Aleksk1/-Tilt_compensated_compass_ATmega328P/Schemes/Compass4_add_grid.pdf

19

20

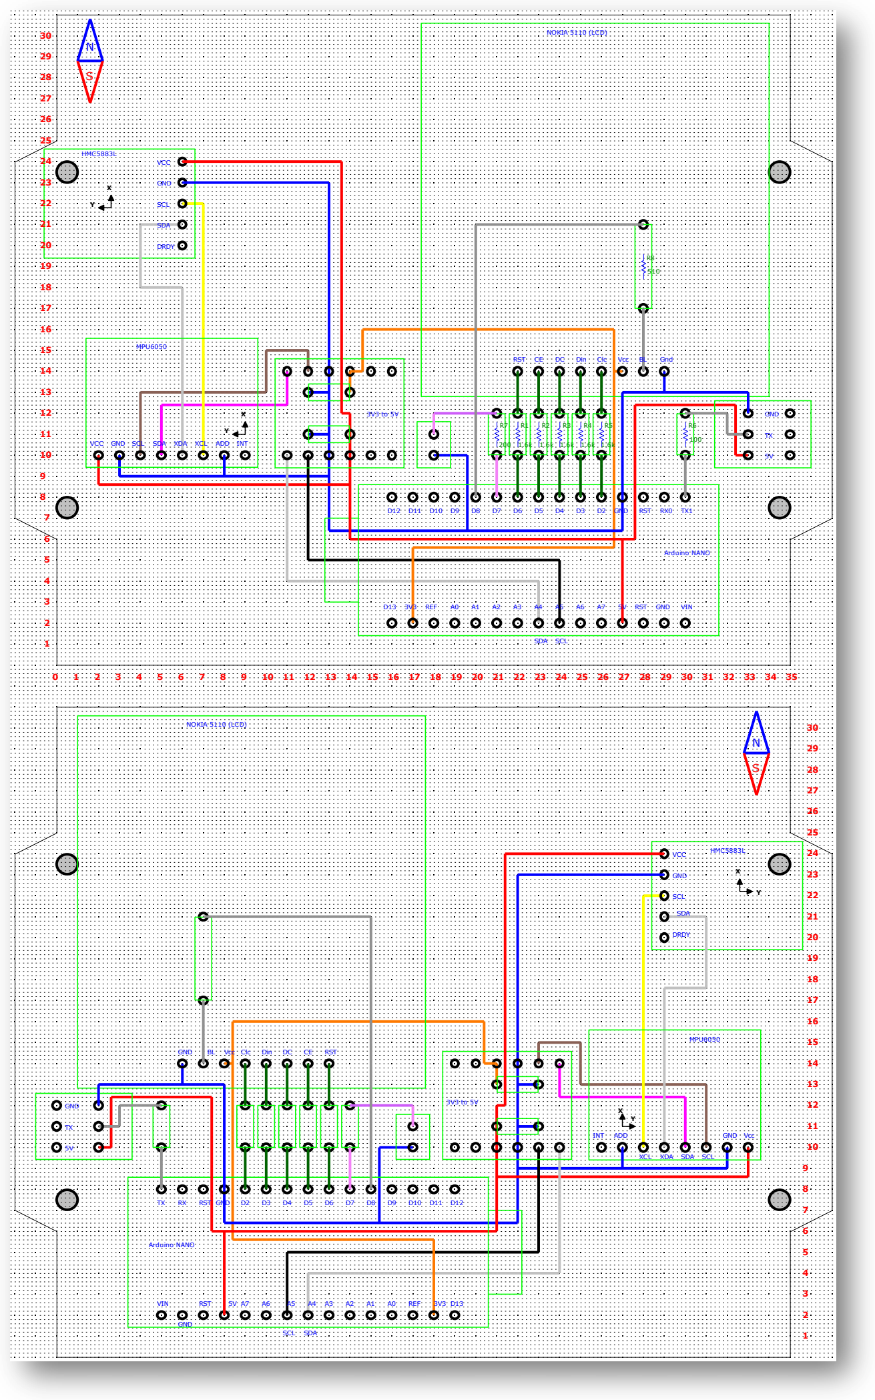
[picture p8: page 1]

R1

1.6k

R2

1.6k

R3

1.6k

R4

1.6k

R5

1.6k

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
1 | 2 | 3 | 4 | 5 | 6 | 7 | 8 | 9 | 10 11 12 13 14 15 16 17 18 19 20 21 22 23 24 25 26 27 28 29 30 31 32

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
RST | CE | DC | Din | Clc | Vcc | BL | Gnd

0 35

N

S

HMC5883L

MPU6050

NOKIA 5110 (LCD)

3V3 to 5V

Arduino NANO

VCC | GND SCL | SDA | XDA | XCL | ADD INT

VCC

GND

SCL

SDA

DRDY

SDA SCL

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
GND | BL | Vcc Clc | Din | DC | CE | RST

N

S

HMC5883L

MPU6050

NOKIA 5110 (LCD)

3V3 to 5V

Arduino NANO

GND Vcc

XCL | XDA | SDA | SCL
INT | ADD

VCC

GND

SCL

SDA

DRDY

SCL SDA

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
33 34
