Aleksk1/-Tilt_compensated_compass_ATmega328P/Photos/freescale_magnetometr.jpg

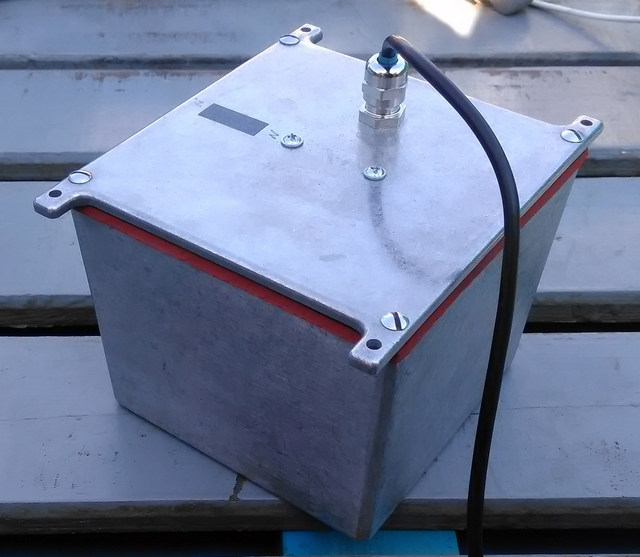
Photos/freescale_magnetometr.jpg
