Aleksk1/-Tilt_compensated_compass_ATmega328P/Schemes/g221c.pdf

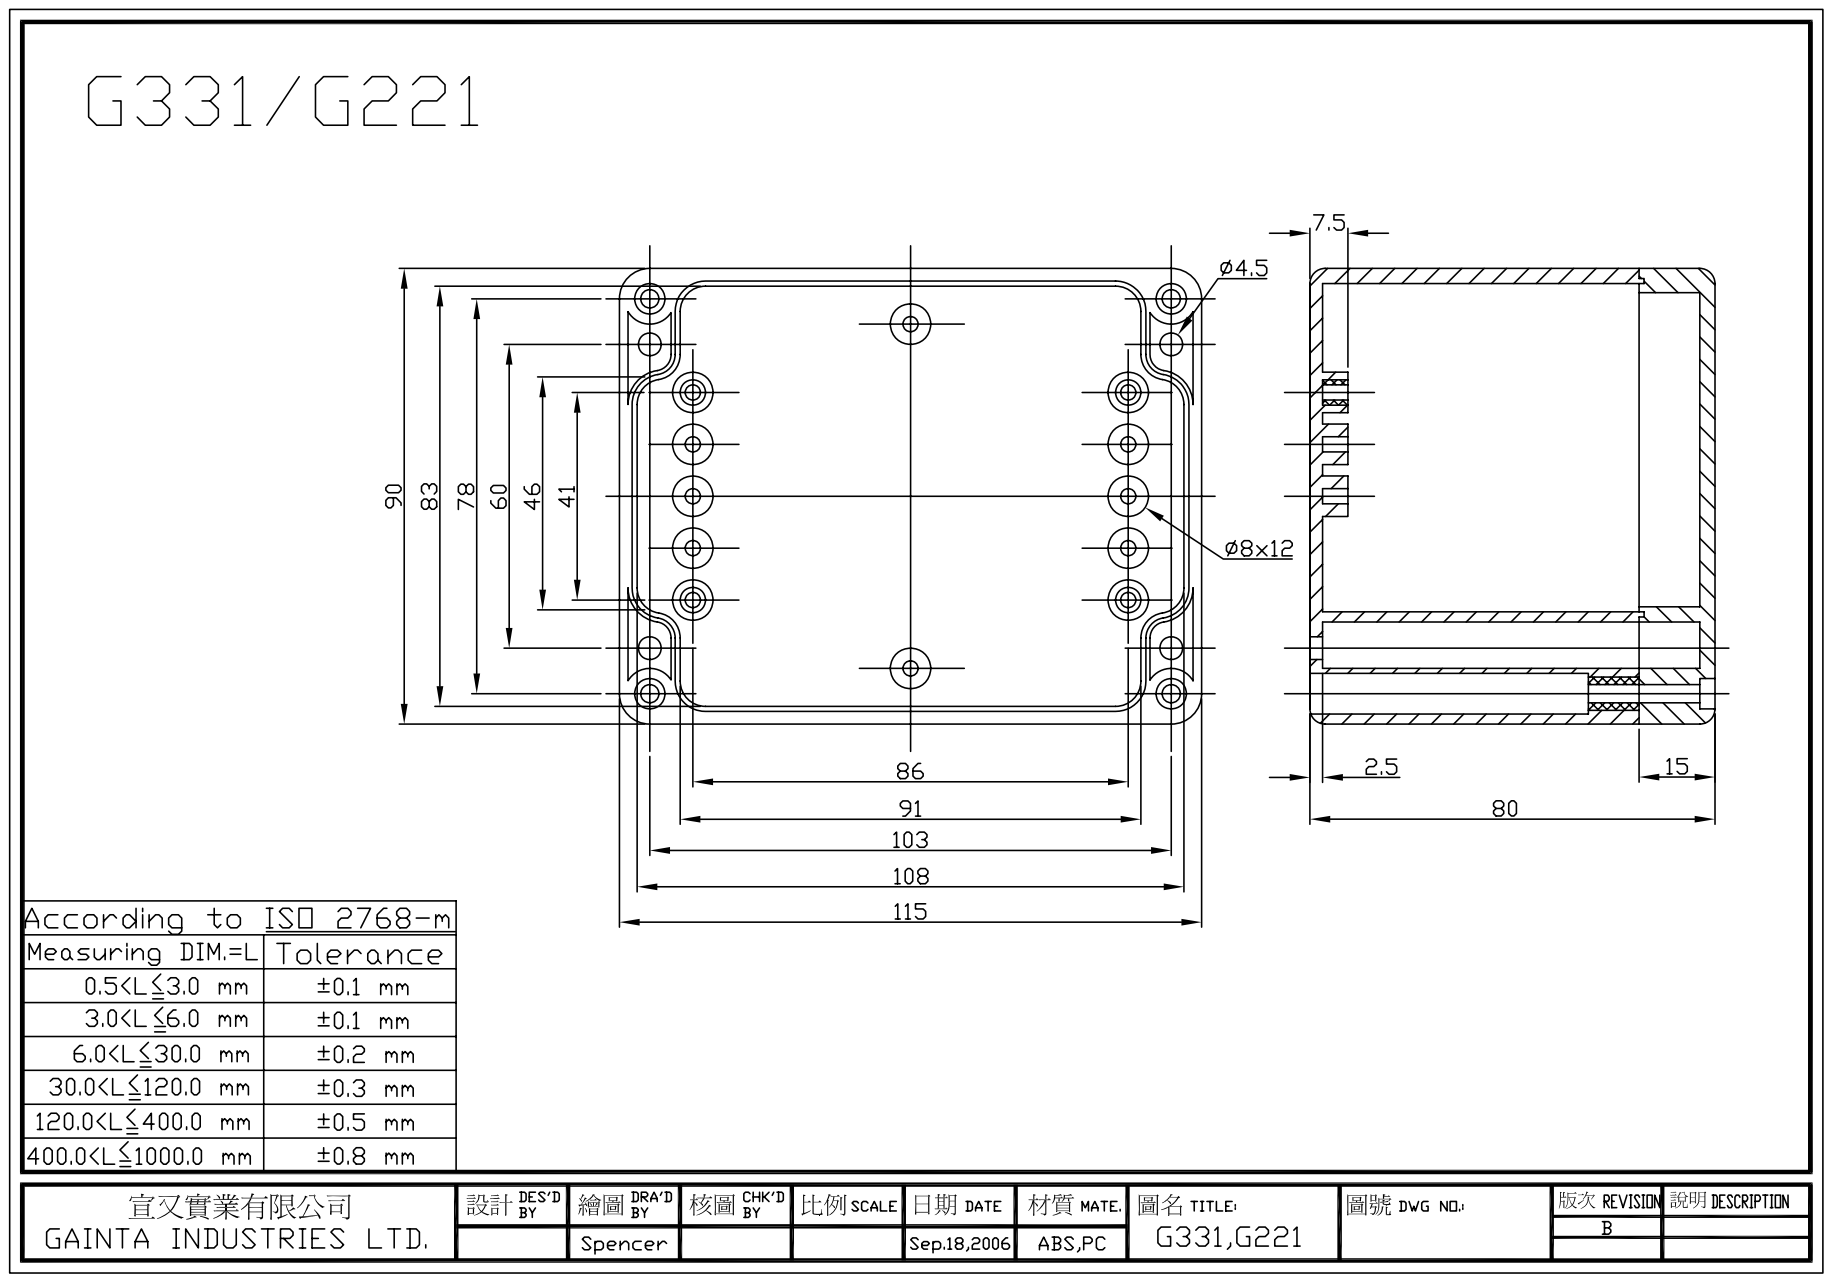
[picture p10: page 1]
