Aleksk1/-Tilt_compensated_compass_ATmega328P/Schemes/Compass4_no_grid.pdf

# Top view

18

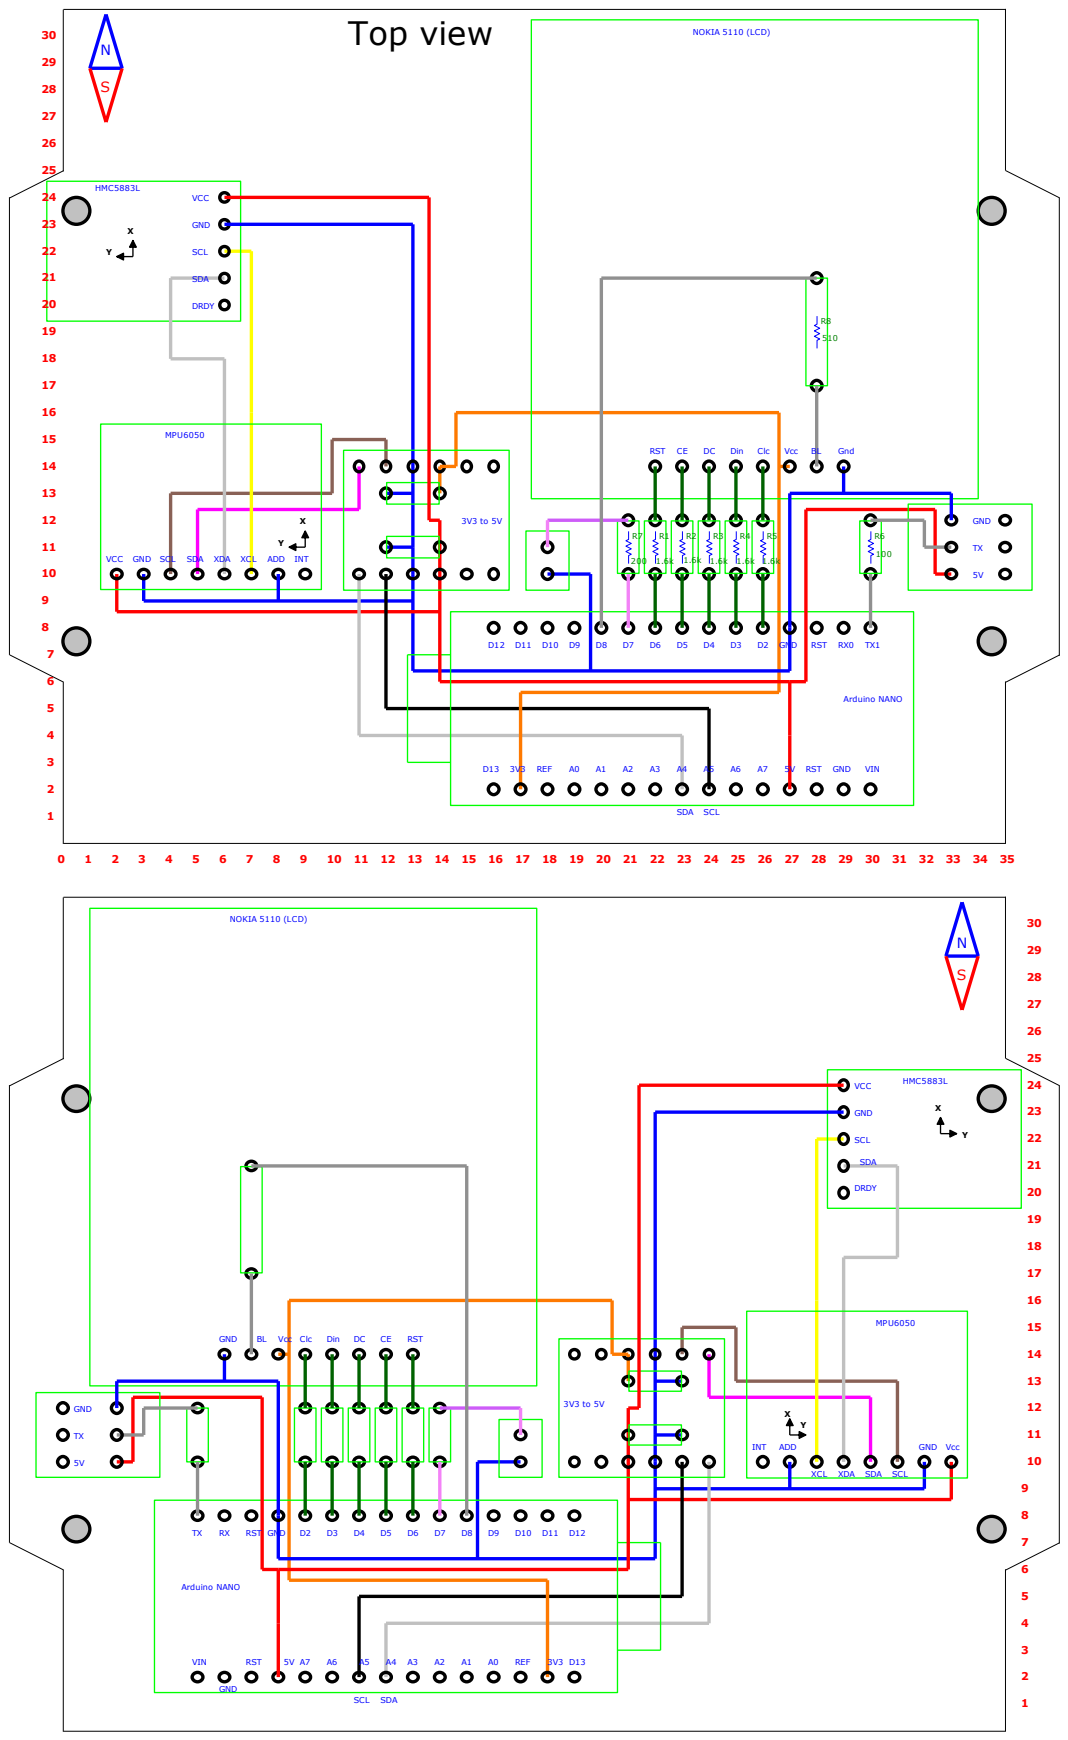
[picture p11: page 1]

SCL

SDA
